skyress3000/rayGPU/README.md

# rayGPU
 3D GPU in VHDL from scratch

 refer to report.pdf for system documentation
